BarakaHarrisK/GEH/assembly/CU-01-BOM.csv

Board | References | Qty per board | Qty for system | Value | Manufacturer part number | Footprint | Procurement requirements
CU-01 | BT1 | 1 | 1 | 18650 3.7V 2600mAh cell 1 | Keystone 1042 | Battery:BatteryHolder_Keystone_1042_1x18650 | Holder only; cells separately listed. Check polarity and cell dimensions.
CU-01 | BT2 | 1 | 1 | 18650 3.7V 2600mAh cell 2 | Keystone 1042 | Battery:BatteryHolder_Keystone_1042_1x18650 | Holder only; cells separately listed. Check polarity and cell dimensions.
CU-01 | C1,C2,C3,C6,C7,C8,C9,C15,C21,C22,C33,C38,C39,C42,C43 | 15 | 15 | 100n |  | Capacitor_SMD:C_0805_2012Metric | 100n; voltage >=stated or 25 V if unstated; X7R unless C0G specified; verify effective capacitance under DC bias; match listed case size.
CU-01 | C10,C16 | 2 | 2 | 10u 25V X7R |  | Capacitor_SMD:C_1210_3225Metric | 10u 25V X7R; voltage >=stated or 25 V if unstated; X7R unless C0G specified; verify effective capacitance under DC bias; match listed case size.
CU-01 | C12,C17,C20,C30,C31,C32 | 6 | 6 | 100n 25V |  | Capacitor_SMD:C_0805_2012Metric | 100n 25V; voltage >=stated or 25 V if unstated; X7R unless C0G specified; verify effective capacitance under DC bias; match listed case size.
CU-01 | C13,C14,C19 | 3 | 3 | 22u 25V X7R |  | Capacitor_SMD:C_1210_3225Metric | 22u 25V X7R; voltage >=stated or 25 V if unstated; X7R unless C0G specified; verify effective capacitance under DC bias; match listed case size.
CU-01 | C18 | 1 | 1 | 3.3n |  | Capacitor_SMD:C_0805_2012Metric | 3.3n; voltage >=stated or 25 V if unstated; X7R unless C0G specified; verify effective capacitance under DC bias; match listed case size.
CU-01 | C23 | 1 | 1 | 47n 25V |  | Capacitor_SMD:C_0805_2012Metric | 47n 25V; voltage >=stated or 25 V if unstated; X7R unless C0G specified; verify effective capacitance under DC bias; match listed case size.
CU-01 | C24,C25 | 2 | 2 | 1u 25V |  | Capacitor_SMD:C_0805_2012Metric | 1u 25V; voltage >=stated or 25 V if unstated; X7R unless C0G specified; verify effective capacitance under DC bias; match listed case size.
CU-01 | C26 | 1 | 1 | 1u 10V |  | Capacitor_SMD:C_0805_2012Metric | 1u 10V; voltage >=stated or 25 V if unstated; X7R unless C0G specified; verify effective capacitance under DC bias; match listed case size.
CU-01 | C27,C28,C29 | 3 | 3 | 10u 25V |  | Capacitor_SMD:C_1210_3225Metric | 10u 25V; voltage >=stated or 25 V if unstated; X7R unless C0G specified; verify effective capacitance under DC bias; match listed case size.
CU-01 | C34,C35 | 2 | 2 | 100n 16V |  | Capacitor_SMD:C_0805_2012Metric | 100n 16V; voltage >=stated or 25 V if unstated; X7R unless C0G specified; verify effective capacitance under DC bias; match listed case size.
CU-01 | C36,C37 | 2 | 2 | 100n 10V |  | Capacitor_SMD:C_0805_2012Metric | 100n 10V; voltage >=stated or 25 V if unstated; X7R unless C0G specified; verify effective capacitance under DC bias; match listed case size.
CU-01 | C4,C5 | 2 | 2 | 1u |  | Capacitor_SMD:C_0805_2012Metric | 1u; voltage >=stated or 25 V if unstated; X7R unless C0G specified; verify effective capacitance under DC bias; match listed case size.
CU-01 | C40,C41 | 2 | 2 | 27p C0G |  | Capacitor_SMD:C_0805_2012Metric | 27p C0G; voltage >=stated or 25 V if unstated; X7R unless C0G specified; verify effective capacitance under DC bias; match listed case size.
CU-01 | D2,D3 | 2 | 2 | BAT46W-E3-08 | BAT46W-E3-08 | Diode_SMD:D_SOD-123 | Use exact MPN and package; no unreviewed substitutions
CU-01 | D4 | 1 | 1 | LTST-C170KGKT | LTST-C170KGKT | LED_SMD:LED_0805_2012Metric | Use exact MPN and package; no unreviewed substitutions
CU-01 | D5 | 1 | 1 | LTST-C170KRKT | LTST-C170KRKT | LED_SMD:LED_0805_2012Metric | Use exact MPN and package; no unreviewed substitutions
CU-01 | D6 | 1 | 1 | BZT52C12-E3-08 | BZT52C12-E3-08 | Diode_SMD:D_SOD-123 | Use exact MPN and package; no unreviewed substitutions
CU-01 | F1,F2 | 2 | 2 | 0451003.MRL 3A 125V | 0451003.MRL | Fuse:Fuse_Littelfuse-NANO2-451_453 | Use exact MPN and package; no unreviewed substitutions
CU-01 | J1 | 1 | 1 | AVR ISP |  | Connector_IDC:IDC-Header_2x03_P2.54mm_Vertical | AVR ISP; standard 2.54 mm header matching listed footprint; pin numbers in connector schedule
CU-01 | J10 | 1 | 1 | CELL TEMPERATURE SENSOR | B2B-XH-A(LF)(SN) | Connector_JST:JST_XH_B2B-XH-A_1x02_P2.50mm_Vertical | JST XH 2-pin; mating XHP-2 with SXH-001T-P0.6 crimp contacts
CU-01 | J2 | 1 | 1 | BUS: mains-only 5 V, GND, SDA, SCL | B4B-XH-A(LF)(SN) | Connector_JST:JST_XH_B4B-XH-A_1x04_P2.50mm_Vertical | JST XH 4-pin; mating XHP-4 with SXH-001T-P0.6 crimp contacts
CU-01 | J3 | 1 | 1 | 4x4 passive keypad |  | Connector_PinHeader_2.54mm:PinHeader_1x08_P2.54mm_Vertical | 4x4 passive keypad; standard 2.54 mm header matching listed footprint; pin numbers in connector schedule
CU-01 | J4 | 1 | 1 | LCD1602 5V 20mA BACKLIGHT |  | Connector_PinHeader_2.54mm:PinHeader_1x16_P2.54mm_Vertical | LCD1602 5V 20mA BACKLIGHT; standard 2.54 mm header matching listed footprint; pin numbers in connector schedule
CU-01 | J5 | 1 | 1 | GSM INTERFACE TO PENDING CIRCUIT |  | Connector_PinHeader_2.54mm:PinHeader_1x04_P2.54mm_Vertical | GSM INTERFACE TO PENDING CIRCUIT; standard 2.54 mm header matching listed footprint; pin numbers in connector schedule
CU-01 | J6 | 1 | 1 | SIM800L HARNESS (not module footprint) | B5B-XH-A(LF)(SN) | Connector_JST:JST_XH_B5B-XH-A_1x05_P2.50mm_Vertical | JST XH 5-pin; mating XHP-5 with SXH-001T-P0.6 crimp contacts
CU-01 | J7 | 1 | 1 | ISOLATED 12 V INPUT | Phoenix Contact 1711725 | TerminalBlock_Phoenix:TerminalBlock_Phoenix_MKDS-3-2-5.08_1x02_P5.08mm_Horizontal | MKDS 3/2-5.08 input terminal; 12 V DC only
CU-01 | J9 | 1 | 1 | CHARGE INHIBIT: short ISET to GND |  | Connector_PinHeader_2.54mm:PinHeader_1x02_P2.54mm_Vertical | CHARGE INHIBIT: short ISET to GND; standard 2.54 mm header matching listed footprint; pin numbers in connector schedule
CU-01 | L2 | 1 | 1 | XAL6030-222MEB 2.2uH | XAL6030-222MEB | Inductor_SMD:L_Coilcraft_XAL6030-XXX | Use exact MPN and package; no unreviewed substitutions
CU-01 | L3 | 1 | 1 | XAL6030-332MEB 3.3uH | XAL6030-332MEB | Inductor_SMD:L_Coilcraft_XAL6030-XXX | Use exact MPN and package; no unreviewed substitutions
CU-01 | Q1 | 1 | 1 | MMBT3904 | MMBT3904LT1G | Package_TO_SOT_SMD:SOT-23 | Use exact MPN and package; no unreviewed substitutions
CU-01 | Q11,Q5 | 2 | 2 | IRFR5305TRPBF | IRFR5305TRPBF | Package_TO_SOT_SMD:TO-252-2 | Use exact MPN and package; no unreviewed substitutions
CU-01 | Q2 | 1 | 1 | MMBT3904 adapter detect | MMBT3904LT1G | Package_TO_SOT_SMD:SOT-23 | Use exact MPN and package; no unreviewed substitutions
CU-01 | Q3,Q4,Q6,Q7 | 4 | 4 | IRLR7843TRPBF | IRLR7843TRPBF | Package_TO_SOT_SMD:TO-252-2 | Use exact MPN and package; no unreviewed substitutions
CU-01 | Q8,Q9,Q10 | 3 | 3 | AO3400A | AO3400A | Package_TO_SOT_SMD:SOT-23 | Use exact MPN and package; no unreviewed substitutions
CU-01 | R1,R4,R17,R21,R36,R54 | 6 | 6 | 10k |  | Resistor_SMD:R_0805_2012Metric | 10k; 0805 >=0.125 W unless footprint is 2512 (>=1 W); stated 0.1% values require precision thin-film; other resistors 1%.
CU-01 | R10,R45 | 2 | 2 | 100k 0.1% |  | Resistor_SMD:R_0805_2012Metric | 100k 0.1%; 0805 >=0.125 W unless footprint is 2512 (>=1 W); stated 0.1% values require precision thin-film; other resistors 1%.
CU-01 | R12 | 1 | 1 | 165k 0.1% |  | Resistor_SMD:R_0805_2012Metric | 165k 0.1%; 0805 >=0.125 W unless footprint is 2512 (>=1 W); stated 0.1% values require precision thin-film; other resistors 1%.
CU-01 | R13,R31 | 2 | 2 | 10k 0.1% |  | Resistor_SMD:R_0805_2012Metric | 10k 0.1%; 0805 >=0.125 W unless footprint is 2512 (>=1 W); stated 0.1% values require precision thin-film; other resistors 1%.
CU-01 | R15,R16 | 2 | 2 | 4k7 provisional |  | Resistor_SMD:R_0805_2012Metric | 4k7 provisional; 0805 >=0.125 W unless footprint is 2512 (>=1 W); stated 0.1% values require precision thin-film; other resistors 1%.
CU-01 | R2,R3 | 2 | 2 | 4.7k |  | Resistor_SMD:R_0805_2012Metric | 4.7k; 0805 >=0.125 W unless footprint is 2512 (>=1 W); stated 0.1% values require precision thin-film; other resistors 1%.
CU-01 | R22,R23 | 2 | 2 | 4.02k |  | Resistor_SMD:R_0805_2012Metric | 4.02k; 0805 >=0.125 W unless footprint is 2512 (>=1 W); stated 0.1% values require precision thin-film; other resistors 1%.
CU-01 | R24,R50,R51 | 3 | 3 | 1k |  | Resistor_SMD:R_0805_2012Metric | 1k; 0805 >=0.125 W unless footprint is 2512 (>=1 W); stated 0.1% values require precision thin-film; other resistors 1%.
CU-01 | R25,R27 | 2 | 2 | 20m 1% 1W |  | Resistor_SMD:R_2512_6332Metric | 20m 1% 1W; 0805 >=0.125 W unless footprint is 2512 (>=1 W); stated 0.1% values require precision thin-film; other resistors 1%.
CU-01 | R26 | 1 | 1 | 10R |  | Resistor_SMD:R_0805_2012Metric | 10R; 0805 >=0.125 W unless footprint is 2512 (>=1 W); stated 0.1% values require precision thin-film; other resistors 1%.
CU-01 | R28 | 1 | 1 | 25.5k 0.1% |  | Resistor_SMD:R_0805_2012Metric | 25.5k 0.1%; 0805 >=0.125 W unless footprint is 2512 (>=1 W); stated 0.1% values require precision thin-film; other resistors 1%.
CU-01 | R29 | 1 | 1 | 2k 0.1% |  | Resistor_SMD:R_0805_2012Metric | 2k 0.1%; 0805 >=0.125 W unless footprint is 2512 (>=1 W); stated 0.1% values require precision thin-film; other resistors 1%.
CU-01 | R30 | 1 | 1 | 23.2k 0.1% |  | Resistor_SMD:R_0805_2012Metric | 23.2k 0.1%; 0805 >=0.125 W unless footprint is 2512 (>=1 W); stated 0.1% values require precision thin-film; other resistors 1%.
CU-01 | R32 | 1 | 1 | 249k 0.1% |  | Resistor_SMD:R_0805_2012Metric | 249k 0.1%; 0805 >=0.125 W unless footprint is 2512 (>=1 W); stated 0.1% values require precision thin-film; other resistors 1%.
CU-01 | R33 | 1 | 1 | 32.4k 0.1% |  | Resistor_SMD:R_0805_2012Metric | 32.4k 0.1%; 0805 >=0.125 W unless footprint is 2512 (>=1 W); stated 0.1% values require precision thin-film; other resistors 1%.
CU-01 | R34 | 1 | 1 | 5.23k 0.1% |  | Resistor_SMD:R_0805_2012Metric | 5.23k 0.1%; 0805 >=0.125 W unless footprint is 2512 (>=1 W); stated 0.1% values require precision thin-film; other resistors 1%.
CU-01 | R35 | 1 | 1 | 30.1k 0.1% |  | Resistor_SMD:R_0805_2012Metric | 30.1k 0.1%; 0805 >=0.125 W unless footprint is 2512 (>=1 W); stated 0.1% values require precision thin-film; other resistors 1%.
CU-01 | R37,R38 | 2 | 2 | 330R |  | Resistor_SMD:R_0805_2012Metric | 330R; 0805 >=0.125 W unless footprint is 2512 (>=1 W); stated 0.1% values require precision thin-film; other resistors 1%.
CU-01 | R39 | 1 | 1 | 2k |  | Resistor_SMD:R_0805_2012Metric | 2k; 0805 >=0.125 W unless footprint is 2512 (>=1 W); stated 0.1% values require precision thin-film; other resistors 1%.
CU-01 | R40 | 1 | 1 | 50m 1% 1W |  | Resistor_SMD:R_2512_6332Metric | 50m 1% 1W; 0805 >=0.125 W unless footprint is 2512 (>=1 W); stated 0.1% values require precision thin-film; other resistors 1%.
CU-01 | R41,R43,R52 | 3 | 3 | 100R |  | Resistor_SMD:R_0805_2012Metric | 100R; 0805 >=0.125 W unless footprint is 2512 (>=1 W); stated 0.1% values require precision thin-film; other resistors 1%.
CU-01 | R42,R44 | 2 | 2 | 62R 1% 1W |  | Resistor_SMD:R_2512_6332Metric | 62R 1% 1W; 0805 >=0.125 W unless footprint is 2512 (>=1 W); stated 0.1% values require precision thin-film; other resistors 1%.
CU-01 | R46,R48 | 2 | 2 | 47k 0.1% |  | Resistor_SMD:R_0805_2012Metric | 47k 0.1%; 0805 >=0.125 W unless footprint is 2512 (>=1 W); stated 0.1% values require precision thin-film; other resistors 1%.
CU-01 | R47 | 1 | 1 | 200k 0.1% |  | Resistor_SMD:R_0805_2012Metric | 200k 0.1%; 0805 >=0.125 W unless footprint is 2512 (>=1 W); stated 0.1% values require precision thin-film; other resistors 1%.
CU-01 | R5,R11,R14,R18,R19,R20,R56,R49,R53 | 9 | 9 | 100k |  | Resistor_SMD:R_0805_2012Metric | 100k; 0805 >=0.125 W unless footprint is 2512 (>=1 W); stated 0.1% values require precision thin-film; other resistors 1%.
CU-01 | R55 | 1 | 1 | 1.50M 0.1% |  | Resistor_SMD:R_0805_2012Metric | 1.50M 0.1%; 0805 >=0.125 W unless footprint is 2512 (>=1 W); stated 0.1% values require precision thin-film; other resistors 1%.
CU-01 | R6 | 1 | 1 | 280R 0.1% |  | Resistor_SMD:R_0805_2012Metric | 280R 0.1%; 0805 >=0.125 W unless footprint is 2512 (>=1 W); stated 0.1% values require precision thin-film; other resistors 1%.
CU-01 | R7 | 1 | 1 | 121R 0.1% |  | Resistor_SMD:R_0805_2012Metric | 121R 0.1%; 0805 >=0.125 W unless footprint is 2512 (>=1 W); stated 0.1% values require precision thin-film; other resistors 1%.
CU-01 | R9 | 1 | 1 | 523k 0.1% |  | Resistor_SMD:R_0805_2012Metric | 523k 0.1%; 0805 >=0.125 W unless footprint is 2512 (>=1 W); stated 0.1% values require precision thin-film; other resistors 1%.
CU-01 | RV1 | 1 | 1 | 3296W-1-103LF 10k | 3296W-1-103LF | Potentiometer_THT:Potentiometer_Bourns_3296W_Vertical | Use exact MPN and package; no unreviewed substitutions
CU-01 | SW1 | 1 | 1 | RESET |  | Button_Switch_THT:SW_PUSH_6mm | 6 x 6 mm through-hole normally-open tactile switch, pin layout matches footprint
CU-01 | U1 | 1 | 1 | ATmega328P-P (DIP-28) | ATMEGA328P-PU | Package_DIP:DIP-28_W7.62mm | Use exact MPN and package; no unreviewed substitutions
CU-01 | U10 | 1 | 1 | HY2120-CB | HY2120-CB | Package_TO_SOT_SMD:SOT-23-6 | Use exact MPN and package; no unreviewed substitutions
CU-01 | U11,U12 | 2 | 2 | HY2213-BB3A | HY2213-BB3A | Package_TO_SOT_SMD:SOT-23-6 | Use exact MPN and package; no unreviewed substitutions
CU-01 | U13 | 1 | 1 | MCP23017-E/SP | MCP23017-E/SP | Package_DIP:DIP-28_W7.62mm | Use exact MPN and package; no unreviewed substitutions
CU-01 | U14 | 1 | 1 | FM24C64B-GTR | FM24C64B-GTR | Package_SO:SOIC-8_3.9x4.9mm_P1.27mm | Use exact MPN and package; no unreviewed substitutions
CU-01 | U2 | 1 | 1 | SN74LVC1T45DBVR TX | SN74LVC1T45DBVR | Package_TO_SOT_SMD:SOT-23-6 | Use exact MPN and package; no unreviewed substitutions
CU-01 | U3 | 1 | 1 | SN74LVC1T45DBVR RX | SN74LVC1T45DBVR | Package_TO_SOT_SMD:SOT-23-6 | Use exact MPN and package; no unreviewed substitutions
CU-01 | U4 | 1 | 1 | TLV75528PDBVR | TLV75528PDBVR | Package_TO_SOT_SMD:SOT-23-5 | Use exact MPN and package; no unreviewed substitutions
CU-01 | U5 | 1 | 1 | LT1764AET#PBF 3A LDO | LT1764AET#PBF | SmartMeter:LT1764A_TO2205_EnhancedPads | Use exact MPN and package; no unreviewed substitutions
CU-01 | U6 | 1 | 1 | TPS62130RGTR - 5 V | TPS62130RGTR | Package_DFN_QFN:VQFN-16-1EP_3x3mm_P0.5mm_EP1.68x1.68mm | Use exact MPN and package; no unreviewed substitutions
CU-01 | U7 | 1 | 1 | TPS3700DDCR | TPS3700DDCR | Package_TO_SOT_SMD:SOT-23-6 | Use exact MPN and package; no unreviewed substitutions
CU-01 | U8 | 1 | 1 | TCA9517ADGKR | TCA9517ADGKR | Package_SO:VSSOP-8_3x3mm_P0.65mm | Use exact MPN and package; no unreviewed substitutions
CU-01 | U9 | 1 | 1 | BQ24133RGYR | BQ24133RGYR | Package_DFN_QFN:Texas_RGY_R-PVQFN-N24_EP2.05x3.1mm | Use exact MPN and package; no unreviewed substitutions
CU-01 | Y1 | 1 | 1 | ABLS-16.000MHZ-B4-T | ABLS-16.000MHZ-B4-T | Crystal:Crystal_HC49-4H_Vertical | Use exact MPN and package; no unreviewed substitutions
