BarakaHarrisK/GEH/assembly/CU-01-assembly.pdf

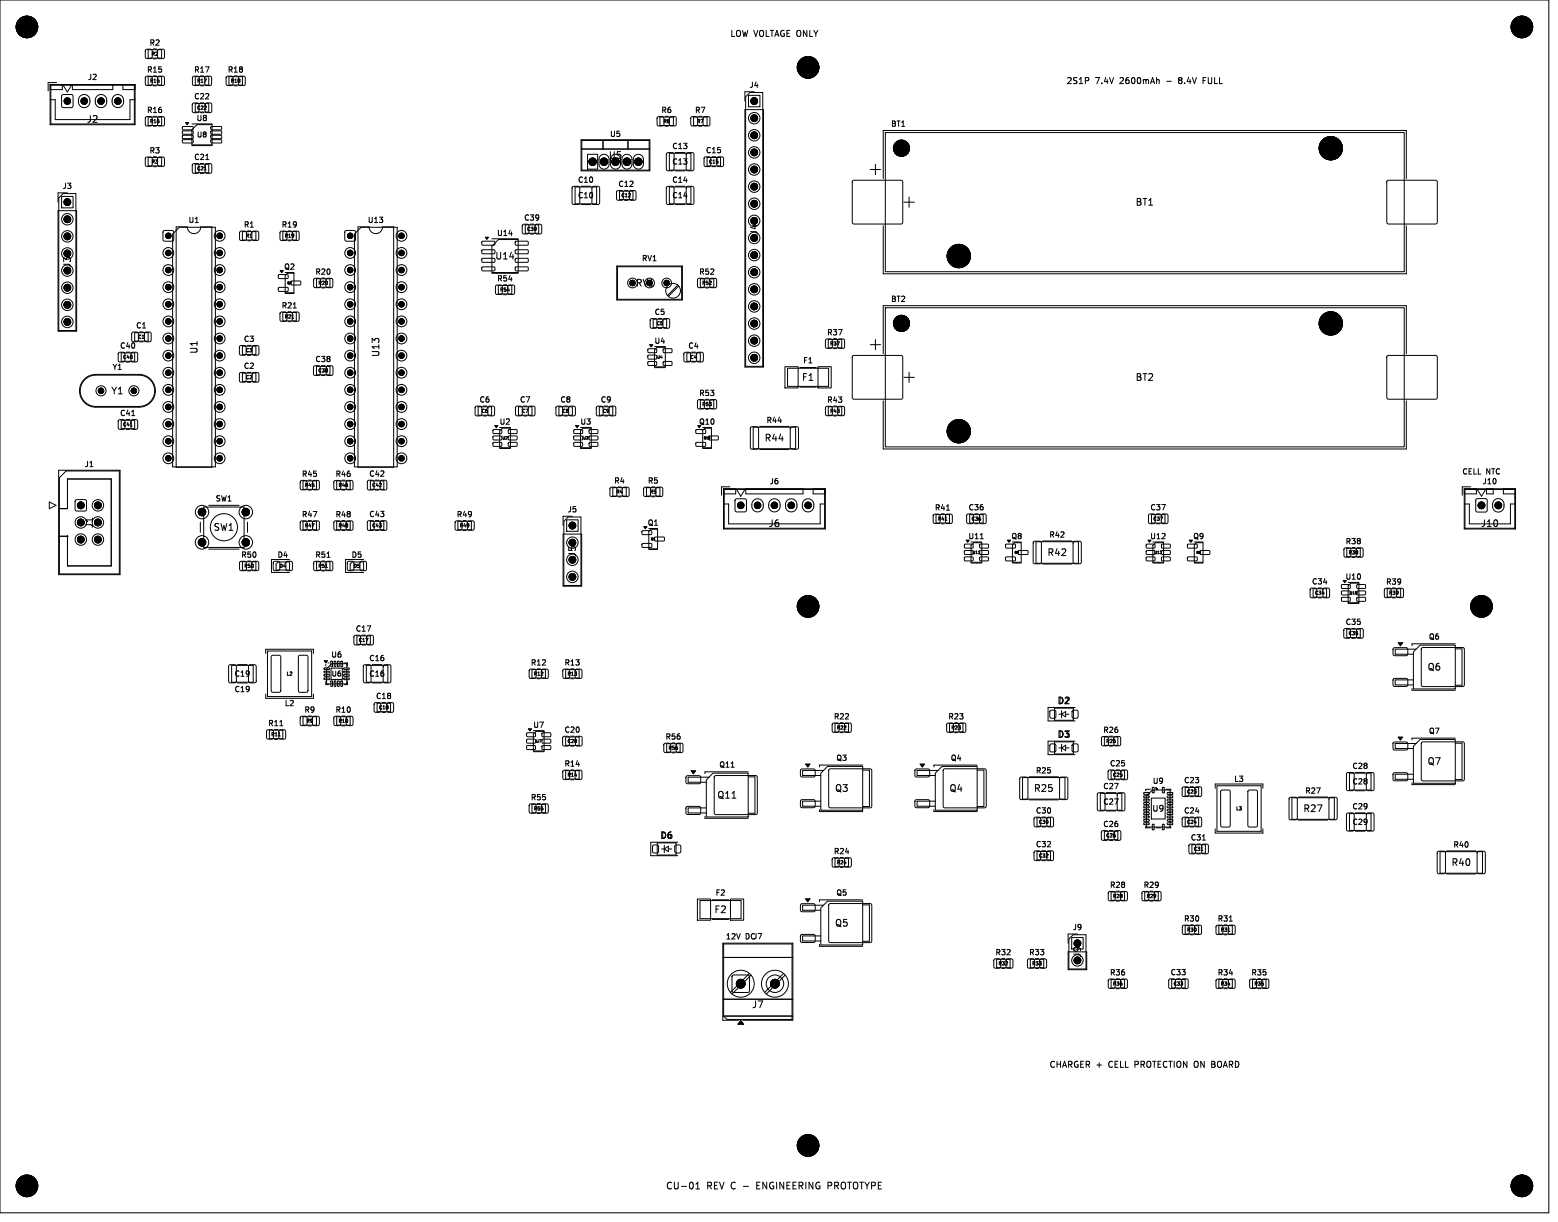
[picture p1: page 1]

CHARGER + CELL PROTECTION ON BOARD
