BarakaHarrisK/GEH/assembly/SU-01-assembly.pdf

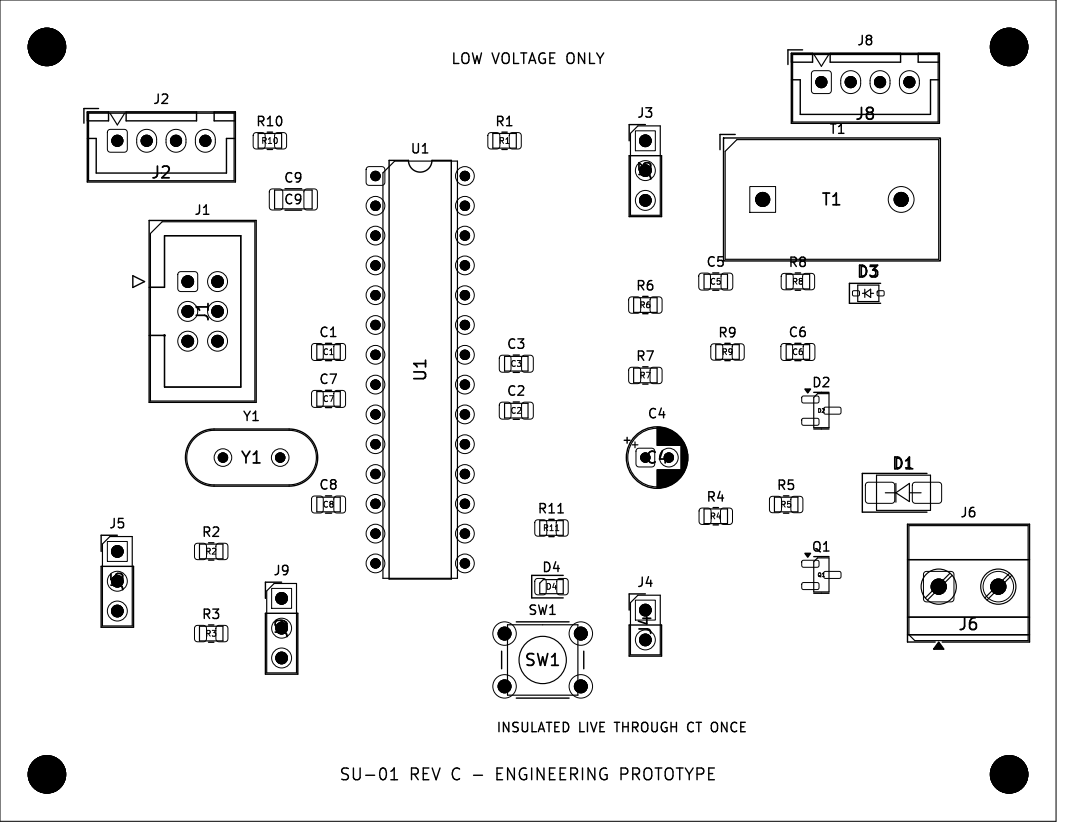
[picture p2: page 1]
