BarakaHarrisK/GEH/cad/SU-01.kicad_pcb

## KiCad design cad/SU-01.kicad_pcb (2026-11-01)

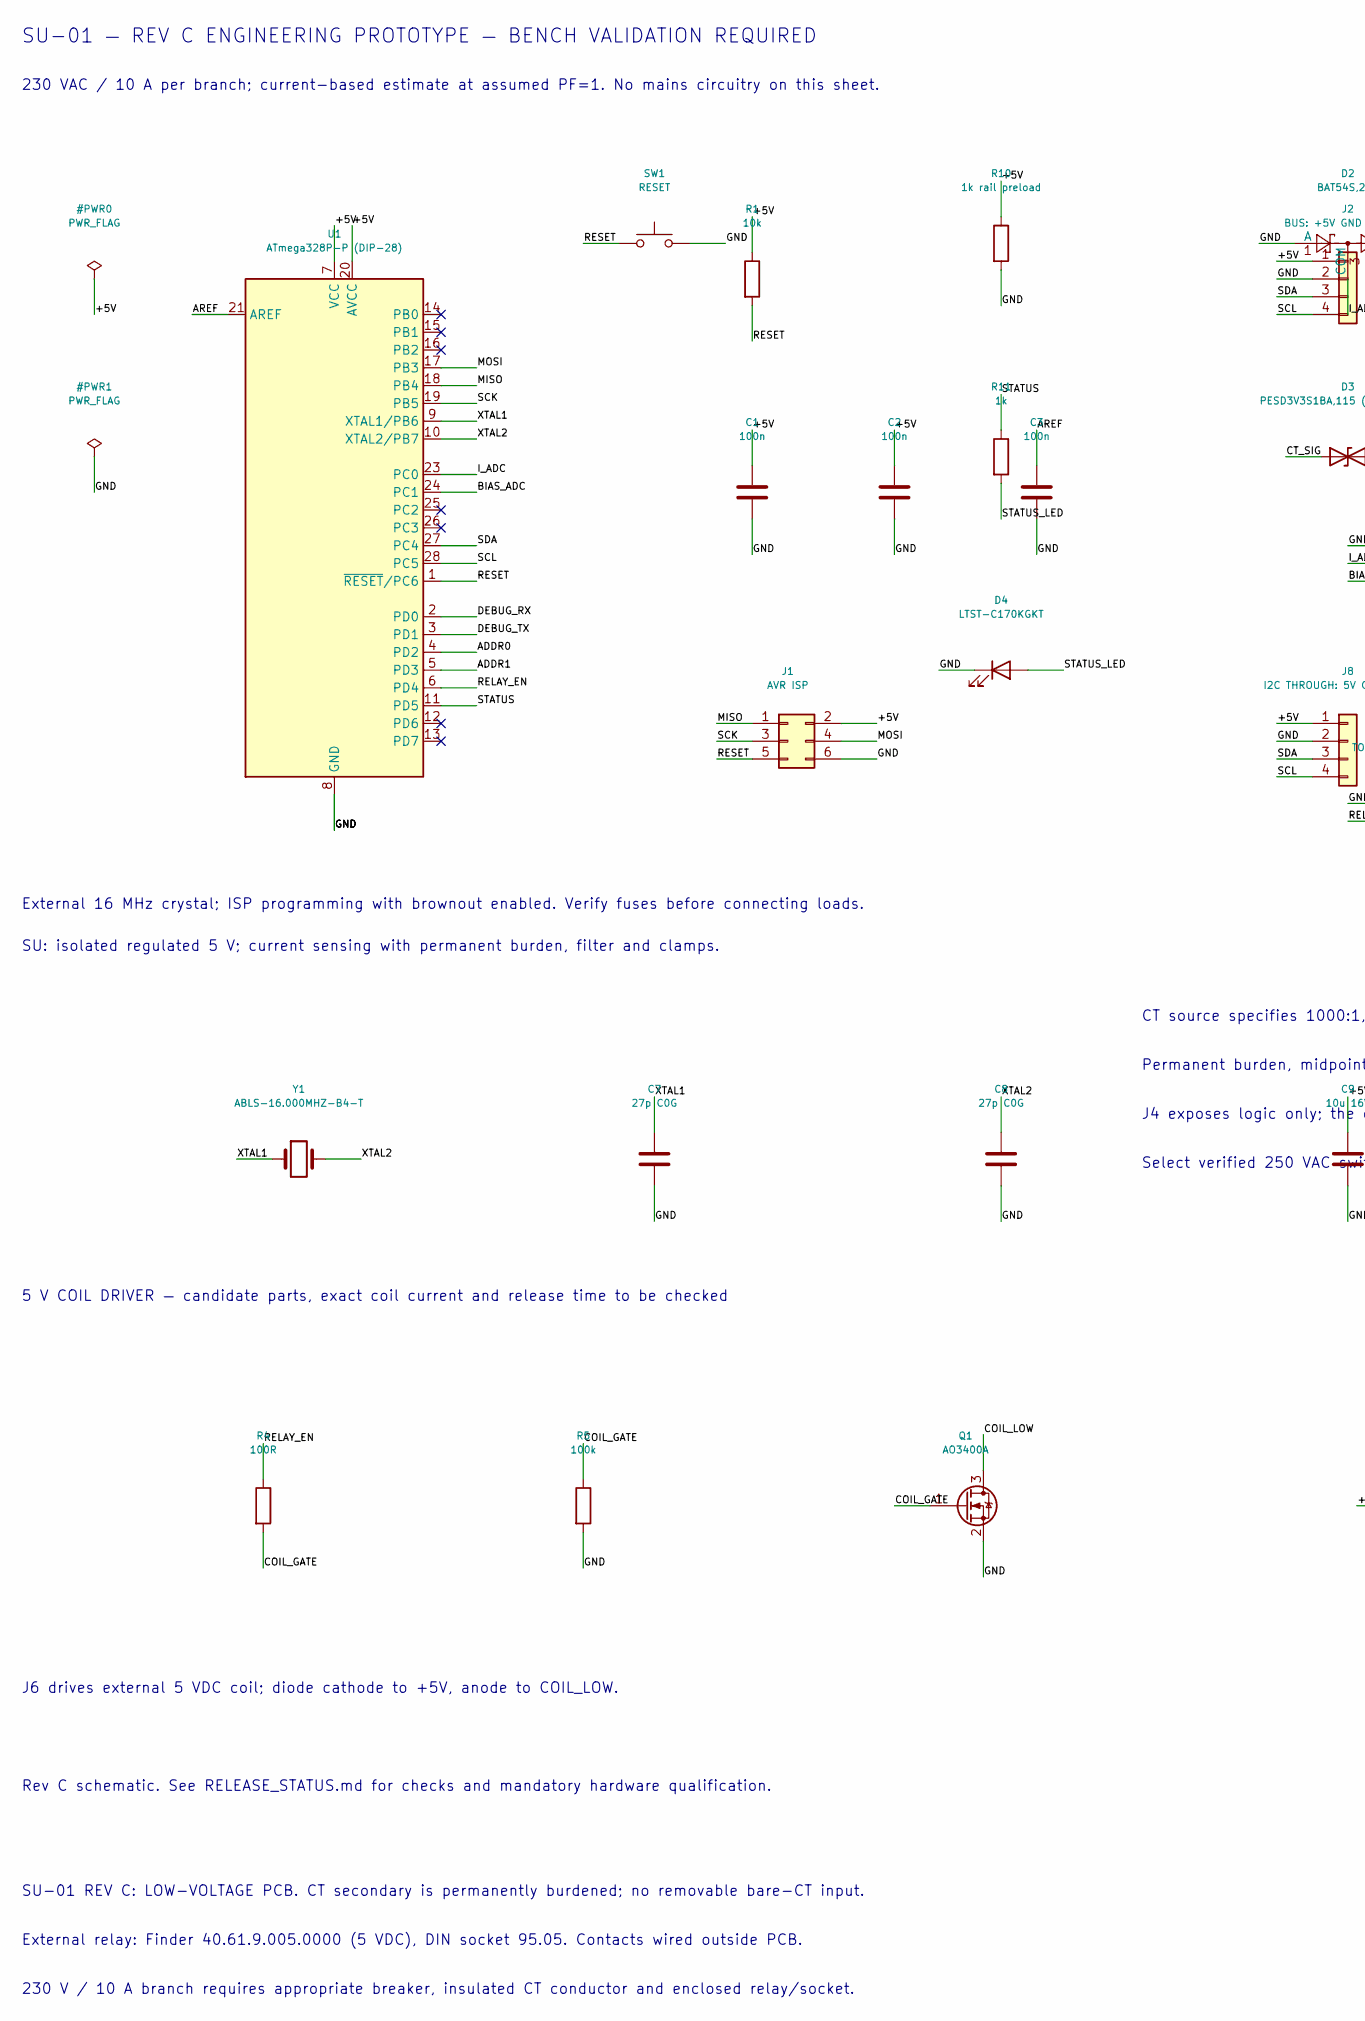
[picture p3: schematic SU-01.kicad_sch, part in row 1, column 1]

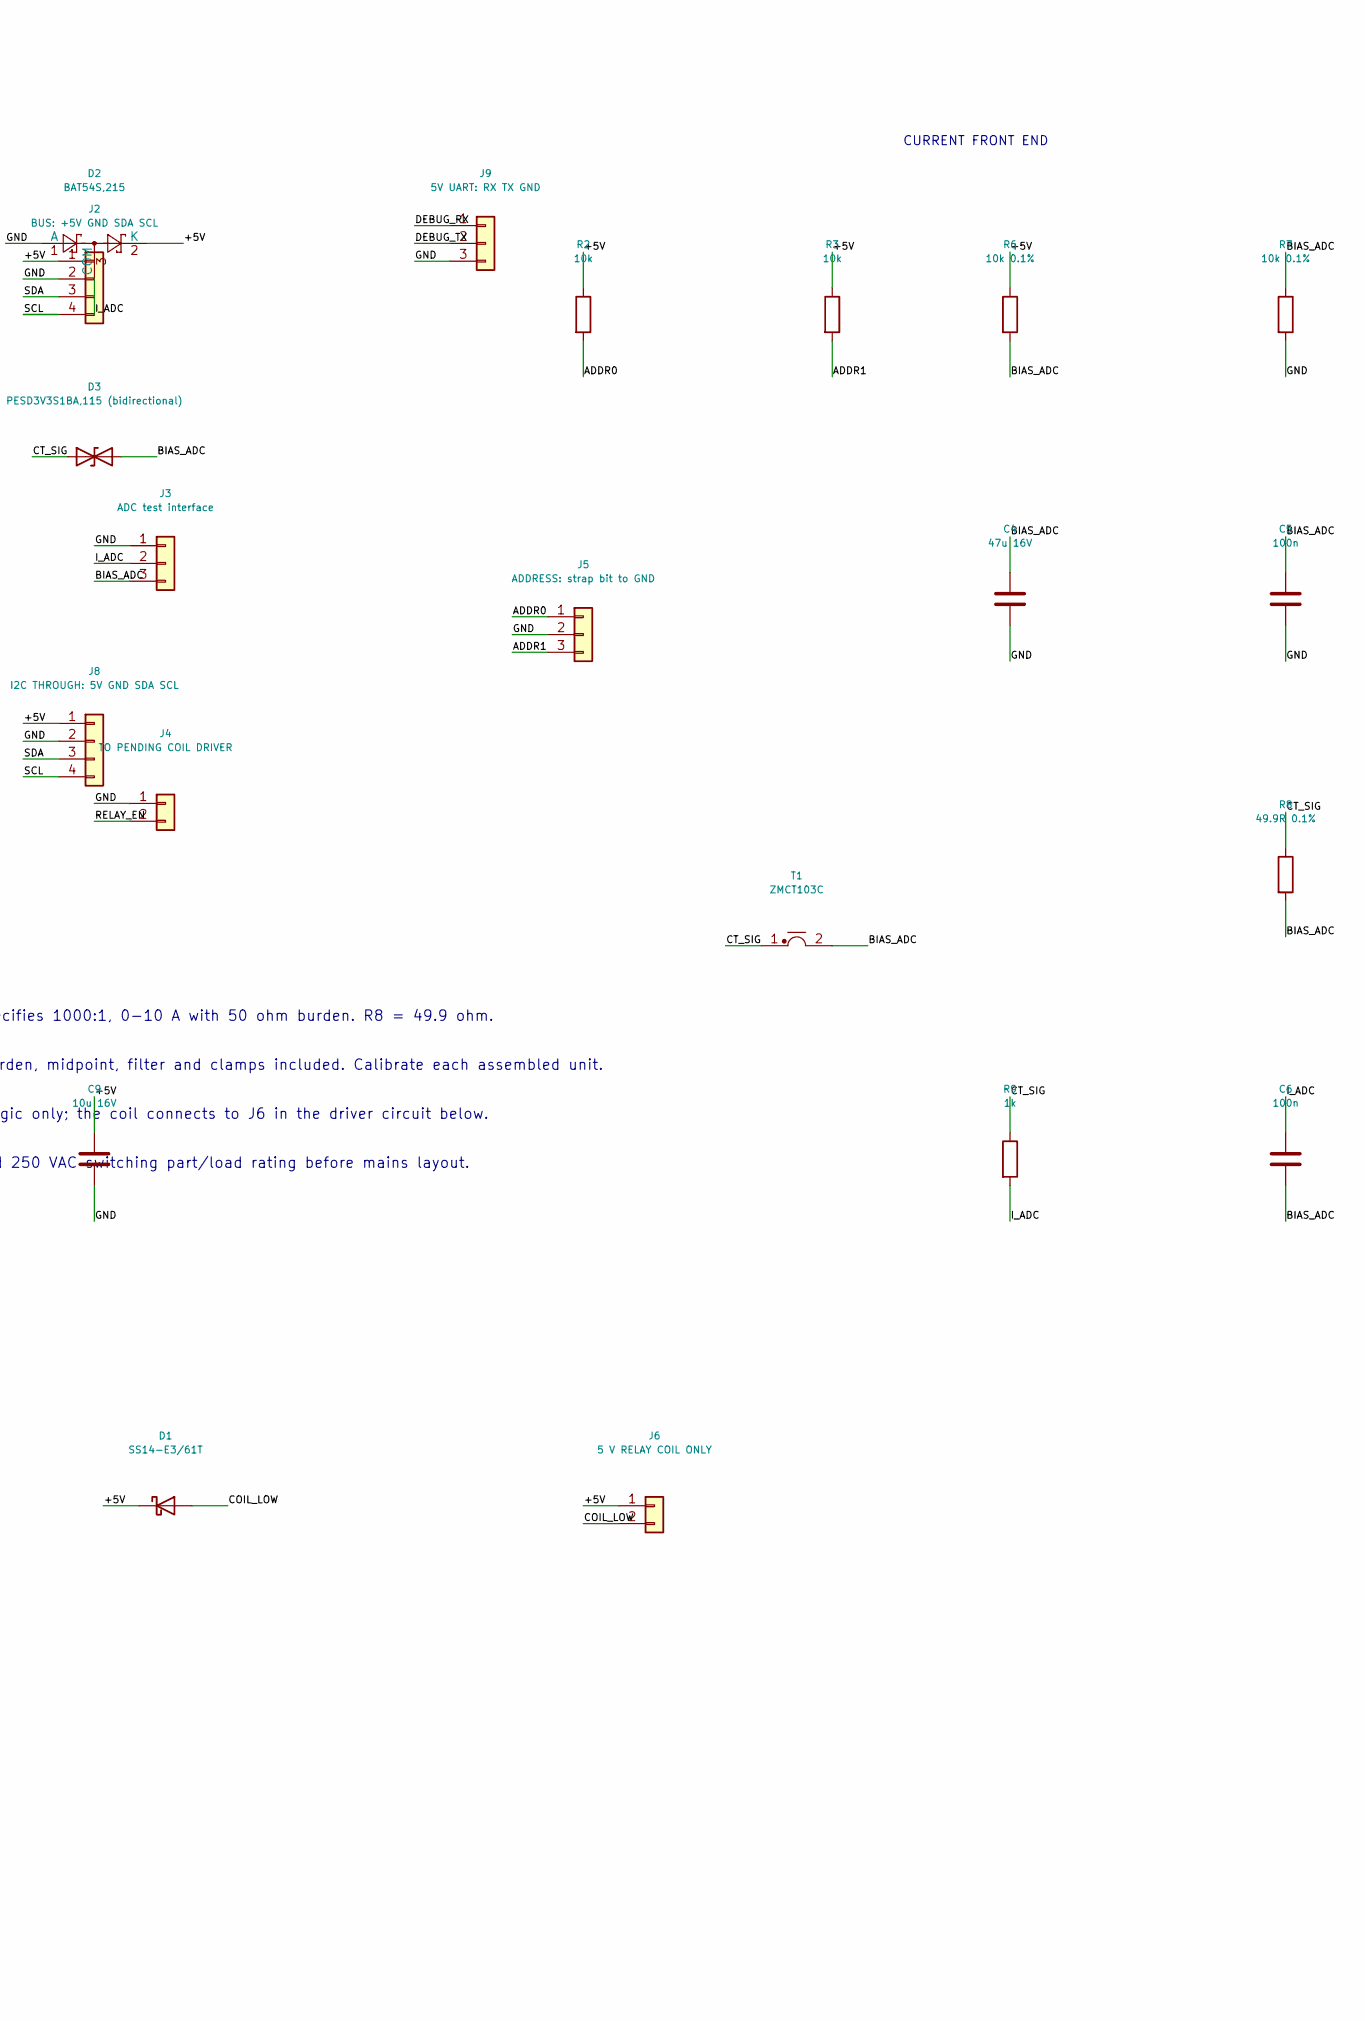
[picture p4: schematic SU-01.kicad_sch, part in row 1, column 2]

Parts:
C1, C2, C3, C5, C6: 100n; C_0805_2012Metric
C4: 47u 16V; CP_Radial_D5.0mm_P2.00mm
C7, C8: 27p C0G; C_0805_2012Metric
C9: 10u 16V; C_1206_3216Metric
D1: SS14-E3/61T; D_SMA
D2: BAT54S,215; SOT-23
D3: PESD3V3S1BA,115 (bidirectional); D_SOD-323
D4: LTST-C170KGKT; LED_0805_2012Metric
J1: AVR ISP; IDC-Header_2x03_P2.54mm_Vertical
J2: BUS: +5V GND SDA SCL; JST_XH_B4B-XH-A_1x04_P2.50mm_Vertical
J3: ADC test interface; PinHeader_1x03_P2.54mm_Vertical
J4: TO PENDING COIL DRIVER; PinHeader_1x02_P2.54mm_Vertical
J5: ADDRESS: strap bit to GND; PinHeader_1x03_P2.54mm_Vertical
J6: 5 V RELAY COIL ONLY; TerminalBlock_Phoenix_MKDS-1,5-2-5.08_1x02_P5.08mm_Horizont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
J8: I2C THROUGH: 5V GND SDA SCL; JST_XH_B4B-XH-A_1x04_P2.50mm_Vertical
J9: 5V UART: RX TX GND; PinHeader_1x03_P2.54mm_Vertical
Q1: AO3400A; SOT-23
R1, R2, R3: 10k; R_0805_2012Metric
R4: 100R; R_0805_2012Metric
R5: 100k; R_0805_2012Metric
R6, R7: 10k 0.1%; R_0805_2012Metric
R8: 49.9R 0.1%; R_0805_2012Metric
R9, R11: 1k; R_0805_2012Metric
R10: 1k rail preload; R_0805_2012Metric
SW1: RESET; SW_PUSH_6mm
T1: ZMCT103C; Transformer_Zeming_ZMCT103C
U1: ATmega328P-P (DIP-28); DIP-28_W7.62mm
Y1: ABLS-16.000MHZ-B4-T; Crystal_HC49-4H_Vertical

Connections:
/ADDR0: J5.1, R2.2, U1.4 (PD2)
/ADDR1: J5.3, R3.2, U1.5 (PD3)
/AREF: C3.1, U1.21 (AREF)
/BIAS_ADC: C4.1, C5.1, C6.2, D3.2 (A2), J3.3, R6.2, R7.1, R8.2, T1.2, U1.24 (PC1)
/COIL_GATE: Q1.1 (G), R4.2, R5.1
/COIL_LOW: D1.2 (A), J6.2, Q1.3 (D)
/CT_SIG: D3.1 (A1), R8.1, R9.1, T1.1
/DEBUG_RX: J9.1, U1.2 (PD0)
/DEBUG_TX: J9.2, U1.3 (PD1)
/I_ADC: C6.1, D2.3 (COM), J3.2, R9.2, U1.23 (PC0)
/MISO: J1.1, U1.18 (PB4)
/MOSI: J1.4, U1.17 (PB3)
/RELAY_EN: J4.2, R4.1, U1.6 (PD4)
/RESET: J1.5, R1.2, SW1.1, U1.1 (~RESET/PC6)
/SCK: J1.3, U1.19 (PB5)
/SCL: J2.4, J8.4, U1.28 (PC5)
/SDA: J2.3, J8.3, U1.27 (PC4)
/STATUS: R11.1, U1.11 (PD5)
/STATUS_LED: D4.2 (A), R11.2
/XTAL1: C7.1, U1.9 (XTAL1/PB6), Y1.1
/XTAL2: C8.1, U1.10 (XTAL2/PB7), Y1.2

Notes on the sheet:
SU-01 — REV C ENGINEERING PROTOTYPE — BENCH VALIDATION REQUIRED
230 VAC / 10 A per branch; current-based estimate at assumed PF=1. No mains circuitry on this sheet.
External 16 MHz crystal; ISP programming with brownout enabled. Verify fuses before connecting loads.
SU: isolated regulated 5 V; current sensing with permanent burden, filter and clamps.
CT source specifies 1000:1, 0-10 A with 50 ohm burden. R8 = 49.9 ohm.
Permanent burden, midpoint, filter and clamps included. Calibrate each assembled unit.
J4 exposes logic only; the coil connects to J6 in the driver circuit below.
Select verified 250 VAC switching part/load rating before mains layout.
CURRENT FRONT END
5 V COIL DRIVER — candidate parts, exact coil current and release time to be checked
J6 drives external 5 VDC coil; diode cathode to +5V, anode to COIL_LOW.
SU-01 REV C: LOW-VOLTAGE PCB. CT secondary is permanently burdened; no removable bare-CT input.
External relay: Finder 40.61.9.005.0000 (5 VDC), DIN socket 95.05. Contacts wired outside PCB.
230 V / 10 A branch requires appropriate breaker, insulated CT conductor and enclosed relay/socket.
Rev C schematic. See RELEASE_STATUS.md for checks and mandatory hardware qualification.

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
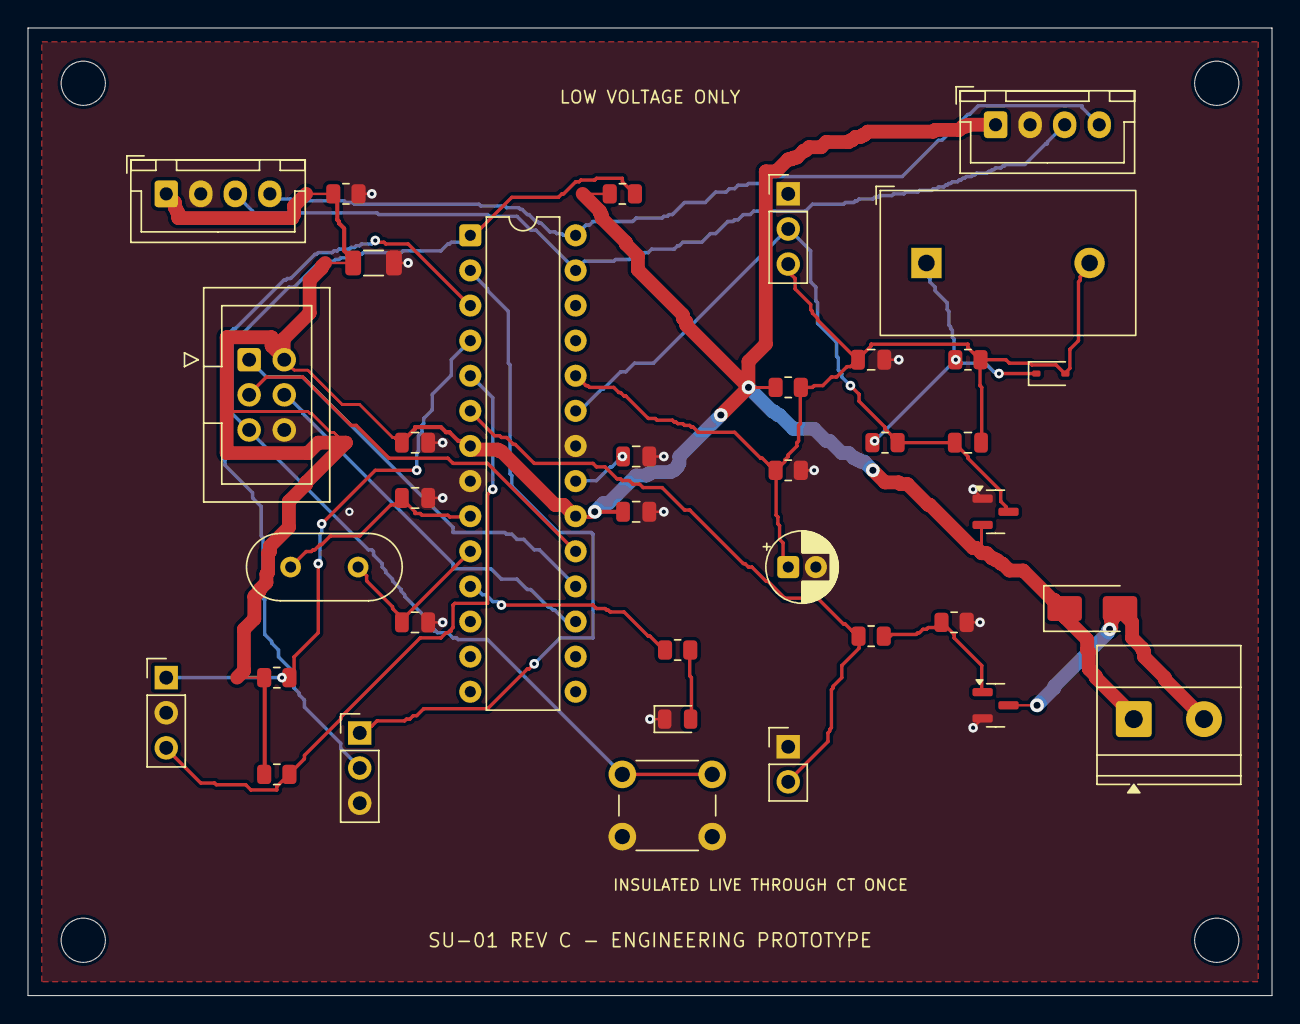
[picture p5: board SU-01.kicad_pcb from above]

Board: 2 copper layers, 90.0 x 70.0 mm, 41 parts (0 on the bottom side), 23 nets.

Other parts of the board:
H1, H2, H3, H4: MountingHole_3.2mm_M3
