BarakaHarrisK/GEH/cad/CU-01.kicad_pcb

## KiCad design cad/CU-01.kicad_pcb (2026-11-01)

Schematic: CU-01.kicad_sch

Parts:
BT1: 18650 3.7V 2600mAh cell 1; BatteryHolder_Keystone_1042_1x18650
BT2: 18650 3.7V 2600mAh cell 2; BatteryHolder_Keystone_1042_1x18650
C1, C2, C3, C6, C7, C8, C9, C15, C21, C22, C33, C38, C39, C42, C43: 100n; C_0805_2012Metric
C4, C5: 1u; C_0805_2012Metric
C10, C16: 10u 25V X7R; C_1210_3225Metric
C12, C17, C20, C30, C31, C32: 100n 25V; C_0805_2012Metric
C13, C14, C19: 22u 25V X7R; C_1210_3225Metric
C18: 3.3n; C_0805_2012Metric
C23: 47n 25V; C_0805_2012Metric
C24, C25: 1u 25V; C_0805_2012Metric
C26: 1u 10V; C_0805_2012Metric
C27, C28, C29: 10u 25V; C_1210_3225Metric
C34, C35: 100n 16V; C_0805_2012Metric
C36, C37: 100n 10V; C_0805_2012Metric
C40, C41: 27p C0G; C_0805_2012Metric
D2, D3: BAT46W-E3-08; D_SOD-123
D4: LTST-C170KGKT; LED_0805_2012Metric
D5: LTST-C170KRKT; LED_0805_2012Metric
D6: BZT52C12-E3-08; D_SOD-123
F1, F2: 0451003.MRL 3A 125V; Fuse_Littelfuse-NANO2-451_453
J1: AVR ISP; IDC-Header_2x03_P2.54mm_Vertical
J2: BUS: mains-only 5 V, GND, SDA, SCL; JST_XH_B4B-XH-A_1x04_P2.50mm_Vertical
J3: 4x4 passive keypad; PinHeader_1x08_P2.54mm_Vertical
J4: LCD1602 5V 20mA BACKLIGHT; PinHeader_1x16_P2.54mm_Vertical
J5: GSM INTERFACE TO PENDING CIRCUIT; PinHeader_1x04_P2.54mm_Vertical
J6: SIM800L HARNESS (not module footprint); JST_XH_B5B-XH-A_1x05_P2.50mm_Vertical
J7: ISOLATED 12 V INPUT; TerminalBlock_Phoenix_MKDS-3-2-5.08_1x02_P5.08mm_Horizontal
J9: CHARGE INHIBIT: short ISET to GND; PinHeader_1x02_P2.54mm_Vertical
J10: CELL TEMPERATURE SENSOR; JST_XH_B2B-XH-A_1x02_P2.50mm_Vertical
L2: XAL6030-222MEB 2.2uH; L_Coilcraft_XAL6030-XXX
L3: XAL6030-332MEB 3.3uH; L_Coilcraft_XAL6030-XXX
Q1: MMBT3904; SOT-23
Q2: MMBT3904 adapter detect; SOT-23
Q3, Q4, Q6, Q7: IRLR7843TRPBF; TO-252-2
Q5, Q11: IRFR5305TRPBF; TO-252-2
Q8, Q9, Q10: AO3400A; SOT-23
R1, R4, R17, R21, R36, R54: 10k; R_0805_2012Metric
R2, R3: 4.7k; R_0805_2012Metric
R5, R11, R14, R18, R19, R20, R49, R53, R56: 100k; R_0805_2012Metric
R6: 280R 0.1%; R_0805_2012Metric
R7: 121R 0.1%; R_0805_2012Metric
R9: 523k 0.1%; R_0805_2012Metric
R10, R45: 100k 0.1%; R_0805_2012Metric
R12: 165k 0.1%; R_0805_2012Metric
R13, R31: 10k 0.1%; R_0805_2012Metric
R15, R16: 4k7 provisional; R_0805_2012Metric
R22, R23: 4.02k; R_0805_2012Metric
R24, R50, R51: 1k; R_0805_2012Metric
R25, R27: 20m 1% 1W; R_2512_6332Metric
R26: 10R; R_0805_2012Metric
R28: 25.5k 0.1%; R_0805_2012Metric
R29: 2k 0.1%; R_0805_2012Metric
R30: 23.2k 0.1%; R_0805_2012Metric
R32: 249k 0.1%; R_0805_2012Metric
R33: 32.4k 0.1%; R_0805_2012Metric
R34: 5.23k 0.1%; R_0805_2012Metric
R35: 30.1k 0.1%; R_0805_2012Metric
R37, R38: 330R; R_0805_2012Metric
R39: 2k; R_0805_2012Metric
R40: 50m 1% 1W; R_2512_6332Metric
R41, R43, R52: 100R; R_0805_2012Metric
R42, R44: 62R 1% 1W; R_2512_6332Metric
R46, R48: 47k 0.1%; R_0805_2012Metric
R47: 200k 0.1%; R_0805_2012Metric
R55: 1.50M 0.1%; R_0805_2012Metric
RV1: 3296W-1-103LF 10k; Potentiometer_Bourns_3296W_Vertical
SW1: RESET; SW_PUSH_6mm
U1: ATmega328P-P (DIP-28); DIP-28_W7.62mm
U2: SN74LVC1T45DBVR TX; SOT-23-6
U3: SN74LVC1T45DBVR RX; SOT-23-6
U4: TLV75528PDBVR; SOT-23-5
U5: LT1764AET#PBF 3A LDO; LT1764A_TO2205_EnhancedPads
U6: TPS62130RGTR - 5 V; VQFN-16-1EP_3x3mm_P0.5mm_EP1.68x1.68mm
U7: TPS3700DDCR; SOT-23-6
U8: TCA9517ADGKR; VSSOP-8_3x3mm_P0.65mm
U9: BQ24133RGYR; Texas_RGY_R-PVQFN-N24_EP2.05x3.1mm
U10: HY2120-CB; SOT-23-6
U11, U12: HY2213-BB3A; SOT-23-6
U13: MCP23017-E/SP; DIP-28_W7.62mm
U14: FM24C64B-GTR; SOIC-8_3.9x4.9mm_P1.27mm
Y1: ABLS-16.000MHZ-B4-T; Crystal_HC49-4H_Vertical

Connections:
/+2V8: C5.1, C7.1, C9.1, U2.6 (VCCB), U3.6 (VCCB), U4.5 (OUT)
/+4V_GSM: C4.1, C13.1, C14.1, C15.1, J6.1, R6.1, U4.1 (IN), U4.3 (EN), U5.4 (OUT)
/+5V: C1.1, C2.1, C6.1, C8.1, C10.1, C12.1, C19.1, C21.1, C38.1, C39.1, J1.2, J4.2, L2.2, R1.1, R2.1, R3.1, R9.1, R11.1, R21.1, R52.1, R54.1, RV1.1, U1.7 (VCC), U1.20 (AVCC), U2.1 (VCCA), U2.5 (DIR), U3.1 (VCCA), U5.2 (IN), U6.14 (VOS), U8.1 (VCCA), U13.9 (VDD), U13.17 (A2), U14.8 (VDD)
/+5V_SERVICE: C22.1, J2.1, R15.1, R16.1, R17.1, U8.8 (VCCB)
/AC_COMMON: Q3.3 (S), Q4.3 (S), R23.2
/AC_DETECT_BASE: Q2.1 (B), R19.2, R20.1
/AC_GATE: Q3.1 (G), Q4.1 (G), R22.2
/AC_SENSE: C30.1, C32.1, Q4.2 (D), R25.1, U9.6 (ACP)
/ADAPTER_12V: F2.1, J7.1
/ADAPTER_FUSED: F2.2, Q11.2 (D)
/ADAPTER_PRESENT_N: Q2.3 (C), R21.2, U1.5 (PD3)
/ADAPTER_PROTECTED: D2.2 (A), D6.1 (K), Q3.2 (D), Q11.3 (S), R19.1, R32.1
/AREF: C3.1, U1.21 (AREF)
/BAL_DRAIN0: Q8.3 (D), R42.2
/BAL_DRAIN1: Q9.3 (D), R44.2
/BAL_GATE0: Q8.1 (G), U11.6 (OUT)
/BAL_GATE1: Q9.1 (G), U12.6 (OUT)
/BAT_GATE: Q5.1 (G), R24.2
/BUS_ENABLE: R17.2, R18.1, U8.5 (EN)
/CELL_POS: BT2.1 (+), F1.1, R37.1, R43.1, R44.1
/CHG_ACDRV: R22.1, U9.8 (ACDRV)
/CHG_ACSET: R30.2, R31.1, U9.17 (ACSET)
/CHG_AVCC_OR: D2.1 (K), D3.1 (K), R26.1
/CHG_BATDRV: R24.1, U9.19 (~BATDRV)
/CHG_BTST: C23.1, U9.21 (BTST)
/CHG_CMSRC: R23.1, U9.7 (CMSRC)
/CHG_ISET: J9.1, R28.2, R29.1, U9.13 (ISET)
/CHG_OVP: R32.2, R33.1, U9.18 (OVPSET)
/CHG_REGN: C24.1, U9.20 (REGN)
/CHG_STAT_N: R36.2, U1.14 (PB0), U9.9 (STAT)
/CHG_SW: C23.2, L3.1, U9.1 (SW), U9.24 (SW)
/CHG_TTC: C33.1, U9.11 (TTC)
/CHG_VREF: C26.1, R28.1, R30.1, R34.1, R36.1, U9.12 (VREF)
/CTRL_FB: R9.2, R10.1, U6.5 (FB)
/CTRL_PG: R11.2, U6.4 (PG)
/CTRL_RUN: R14.2, R55.1, U6.13 (EN), U7.1 (OUTA)
/CTRL_SS: C18.1, U6.9 (SS/TR)
/CTRL_SW: L2.1, U6.1 (SW), U6.2 (SW), U6.3 (SW)
/FAULT_LED: R51.1, U1.13 (PD7)
/GND: C1.2, C2.2, C3.2, C4.2, C5.2, C6.2, C7.2, C8.2, C9.2, C10.2, C12.2, C13.2, C14.2, C15.2, C16.2, C17.2, C18.2, C19.2, C20.2, C21.2, C22.2, C24.2, C25.2, C26.2, C27.2, C28.2, C29.2, C32.2, C33.2, C38.2, C39.2, C40.2, C41.2, C42.2, C43.2, D4.1 (K), D5.1 (K), J1.6, J2.2, J4.1, J4.5, J5.1, J6.2, J7.2, J9.2, J10.2, Q1.2 (E), Q2.2 (E), Q10.2 (S), R5.2, R7.2, R10.2, R13.2, R18.2, R20.2, R29.2, R31.2, R33.2, R35.2, R39.1, R40.2, R46.2, R48.2, R49.2, R53.2, R56.2, RV1.3, SW1.2, U1.8 (GND), U1.22 (GND), U2.2 (GND), U3.2 (GND), U3.5 (DIR), U4.2 (GND), U5.3 (GND), U6.6 (GND), U6.8 (DEF), U6.15 (GND), U6.16 (GND), U6.17 (GND), U7.2 (GND), U7.4 (INB-), U8.4 (GND), U9.22 (PGND), U9.23 (PGND), U9.25 (AGND), U13.10 (VSS), U13.15 (A0), U13.16 (A1), U14.1 (A0), U14.2 (A1), U14.3 (A2), U14.4 (VSS), U14.7 (WP)
/GSM_ENABLE: R49.1, U1.6 (PD4), U5.1 (~SHDN)
/GSM_FB: R6.2, R7.1, U5.5 (ADJ)
/GSM_RESET_CTL: J5.4, R4.1, U1.11 (PD5)
/GSM_RX_5V: J5.3, U1.2 (PD0), U3.3 (A)
/GSM_TX_5V: J5.2, U1.3 (PD1), U2.3 (A)
/IO_INT_N: R54.2, U1.4 (PD2), U13.19 (INTB)
/KEY_C1: J3.5, U13.5 (GPB4)
/KEY_C2: J3.6, U13.6 (GPB5)
/KEY_C3: J3.7, U13.7 (GPB6)
/KEY_C4: J3.8, U13.8 (GPB7)
/KEY_R1: J3.1, U13.1 (GPB0)
/KEY_R2: J3.2, U13.2 (GPB1)
/KEY_R3: J3.3, U13.3 (GPB2)
/KEY_R4: J3.4, U13.4 (GPB3)
/LCD_A: J4.15, R52.2
/LCD_BL_GATE: Q10.1 (G), R53.1, U13.27 (GPA6)
/LCD_D4: J4.11, U13.23 (GPA2)
/LCD_D5: J4.12, U13.24 (GPA3)
/LCD_D6: J4.13, U13.25 (GPA4)
/LCD_D7: J4.14, U13.26 (GPA5)
/LCD_E: J4.6, U13.22 (GPA1)
/LCD_K: J4.16, Q10.3 (D)
/LCD_RS: J4.4, U13.21 (GPA0)
/LCD_VO: J4.3, RV1.2
/LED_GREEN: D4.2 (A), R50.2
/LED_RED: D5.2 (A), R51.2
/MISO: J1.1, U1.18 (PB4)
/MOSI: J1.4, U1.17 (PB3)
/PACK_ADC: C42.1, R45.2, R46.1, U1.23 (PC0)
/PACK_NTC: J10.1, R34.2, R35.1, U9.10 (TS)
/PACK_PROTECTED: C28.1, C29.1, C31.2, D3.2 (A), F1.2, Q5.2 (D), R27.2, R45.1, U9.15 (SRN)
/PCM_CS: R39.2, U10.3 (CS)
/PCM_DRAIN: Q6.2 (D), Q7.2 (D)
/PCM_OC: Q7.1 (G), U10.2 (OC)
/PCM_OD: Q6.1 (G), U10.1 (OD)
/PCM_SOURCE: Q7.3 (S), R40.1
/PCM_VC: C34.2, C35.1, R38.2, U10.4 (VC)
/RESET: J1.5, R1.2, SW1.1, U1.1 (~RESET/PC6), U13.18 (~RESET)
/RESET_BASE: Q1.1 (B), R4.2, R5.1
/REV_GATE: D6.2 (A), Q11.1 (G), R56.1
/SCK: J1.3, U1.19 (PB5)
/SCL: R3.2, U1.28 (PC5), U8.2 (SCLA), U13.12 (SCK), U14.6 (SCL)
/SCL_BUS: J2.4, R16.2, U8.7 (SCLB)
/SDA: R2.2, U1.27 (PC4), U8.3 (SDAA), U13.13 (SDA), U14.5 (SDA)
/SDA_BUS: J2.3, R15.2, U8.6 (SDAB)
/SIM_RST: J6.5, Q1.3 (C)
/SIM_RXD: J6.3, U2.4 (B)
/SIM_TXD: J6.4, U3.4 (B)
/STATUS_LED: R50.1, U1.12 (PD6)
/SYS_ADC: C43.1, R47.2, R48.1, U1.24 (PC1)
/SYS_RAW: C16.1, C17.1, C20.1, C27.1, C30.2, Q5.3 (S), R12.1, R14.1, R25.2, R47.1, U6.7 (FSW), U6.10 (VIN), U6.11 (VIN), U6.12 (VIN), U7.5 (VDD), U9.2 (PVCC), U9.3 (PVCC), U9.5 (ACN)
/SYS_UV: R12.2, R13.1, R55.2, U7.3 (INA+)
/XTAL1: C40.1, U1.9 (XTAL1/PB6), Y1.1
/XTAL2: C41.1, U1.10 (XTAL2/PB7), Y1.2

Notes on the sheet:
CU-01 — REV C ENGINEERING PROTOTYPE — BENCH VALIDATION REQUIRED
230 VAC / 10 A per branch; current-based estimate at assumed PF=1. No mains circuitry on this sheet.
External 16 MHz crystal; ISP programming with brownout enabled. Verify fuses before connecting loads.
CU: isolated 12 V input + protected 2S backup; service 5 V separate.
J5 is a logic test header; translated module signals are on J6.
GSM supply / translation below; J6 harness to SIM800L. FRAM and IO expander included.
J4 is a full 16-pin LCD interface; contrast and limited-current backlight included.
LCD/keypad use U13 I2C expander; ISP pins are dedicated.
GSM UART TRANSLATION — 5 V A-side / 2.8 V B-side
Verify module pin labels and reset pull-up before connecting.
2.8 V follows GSM 4 V supply; avoid UART drive in module soft-off.
GSM 4.01 V / 3 A LOW-NOISE LDO FROM BACKED 5 V
VOUT = 1.21 * (1 + 280/121) ~= 4.01 V. TO-220 tab is GND.
Regulator input is the 5 V buck. Qualify heat sink and 2 A radio bursts at worst ambient.
Minimum output capacitance 10 uF; retain module-local bulk capacitor and short power harness.
No fabrication release: verify exact MPNs/footprints, protection, mechanics and ERC.
Rev C schematic. See RELEASE_STATUS.md for checks and mandatory hardware qualification.
2S 18650 BACKUP — CANDIDATE CIRCUIT / MODULE INTERFACES
2S1P: 7.4 V nominal, 8.4 V full. 2600 mAh / 19.24 Wh nominal. Charge current 0.60 A.
CELL_NEG must NOT be shorted to GND (P-); no raw-cell load path.
5 V CONTROLLER BUCK + LOW-VOLTAGE CUTOFF
External hysteresis: SYS starts ~7.04 V / stops ~6.30 V. Verify tolerances and burst recovery.
No runtime guarantee: usable Wh, GSM activity, LCD load, losses and cutoff need measurement.
BACKUP BUS ISOLATION — service boards remain mains powered
J2 pin 1 is now mains-only +5V_SERVICE, not battery-backed +5V. Supply it externally.
U8 isolates I2C when the service supply is off; validate all power-up/down combinations.
PB6 / DIP pin 9: low = adapter present; high = adapter lost. No crystal on this pin.
Firmware should save state, report outage and reduce LCD load; hard cutoff is independent.
INTEGRATED CHARGER / POWER PATH — BQ24133, hardware-selected 2S, 0.60 A target
CELL pin intentionally NC = 2S / 8.4 V. 100 nF TTC gives ~9.33 h fast-charge timer. NTC = Semitec 103AT-2 (on cells).
OVP nominal 13.90 V; adapter-valid lower threshold 4.34 V. ACSET = 2.50 A input limit. Verify Kelvin sense and thermal layout.
INTEGRATED CELL PROTECTION AND BALANCING
Per-cell HY2213 balancing begins near 4.2 V; 62 ohm bleeds approximately 68 mA / 0.285 W.
BMS OC/OD thresholds are independent of charger. Pack fuse and 50 milliohm shunt remain mandatory.
CONTROLLER I/O / CLOCK / NONVOLATILE RECORDS
I2C: MCP23017=0x24, FM24C64B=0x50; service units=0x20..0x23.
16 MHz crystal: CL=18pF; 27p capacitors assume ~4.5pF stray. Keep oscillator loop short.
LCD pin 1=GND, 2=5V, 3=VO, 4=RS, 5=GND, 6=E, 11..14=D4..D7, 15=A,16=K.
ISP lines are dedicated. Disable GSM rail via PD4 before module power-down to avoid UART phantom supply.

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
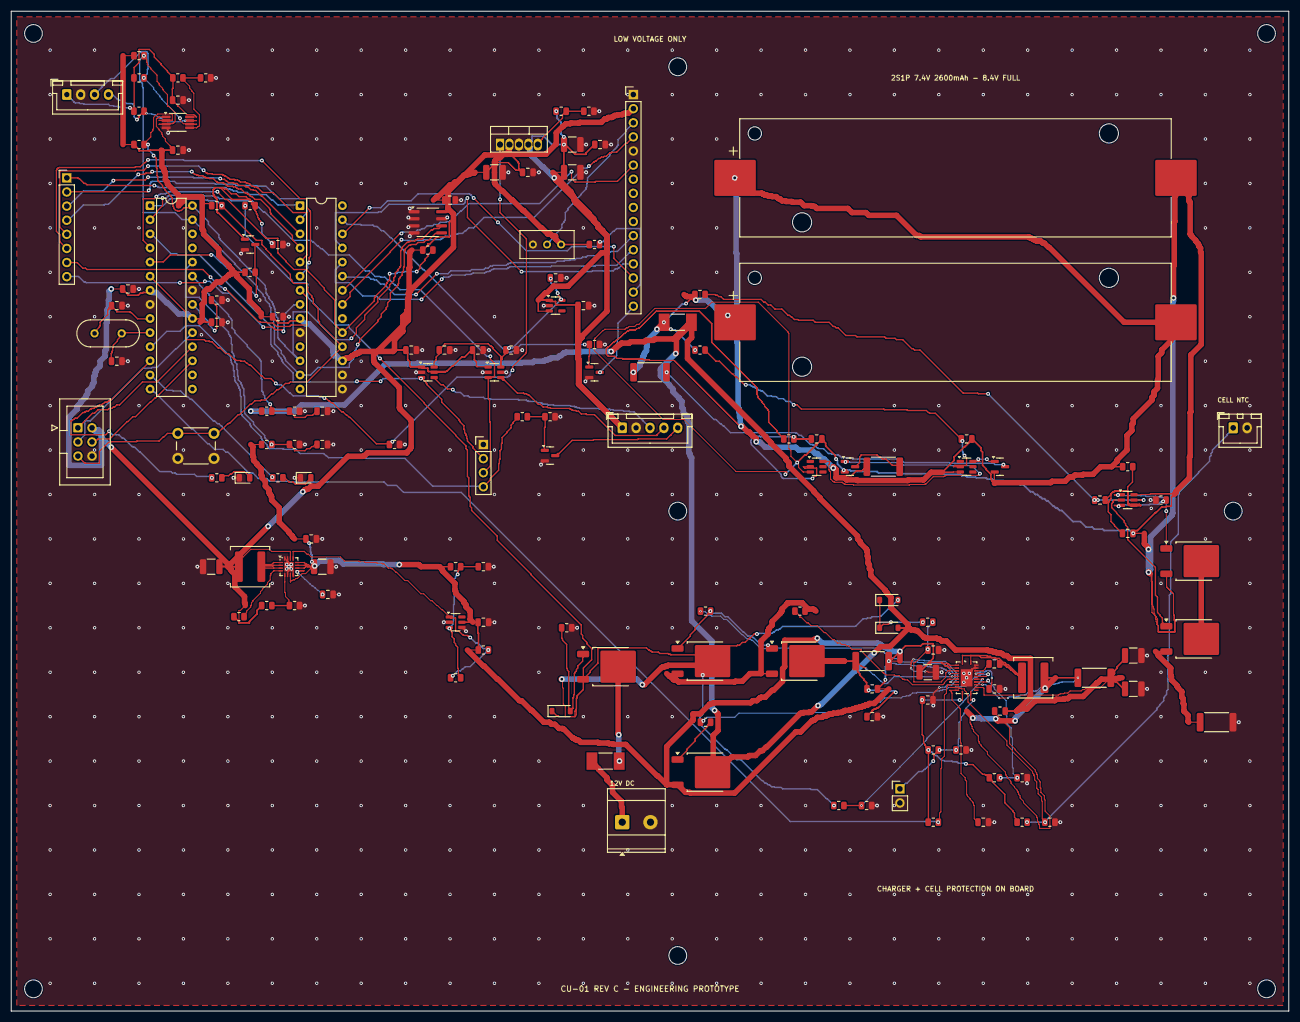
[picture p6: board CU-01.kicad_pcb from above]

Board: 2 copper layers, 230.0 x 180.0 mm, 153 parts (0 on the bottom side), 101 nets.

Other parts of the board:
H1, H2, H3, H4, H5, H6, H7, H8: MountingHole_3.2mm_M3
